azilnik/kindle-sky/docs/images/frame.jpg

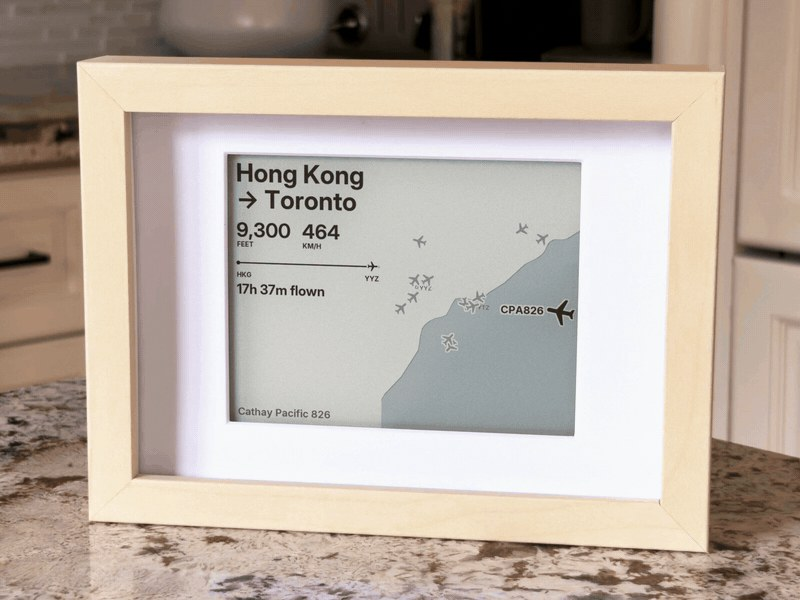
docs/images/frame.jpg
