azilnik/kindle-sky/docs/images/hero.png

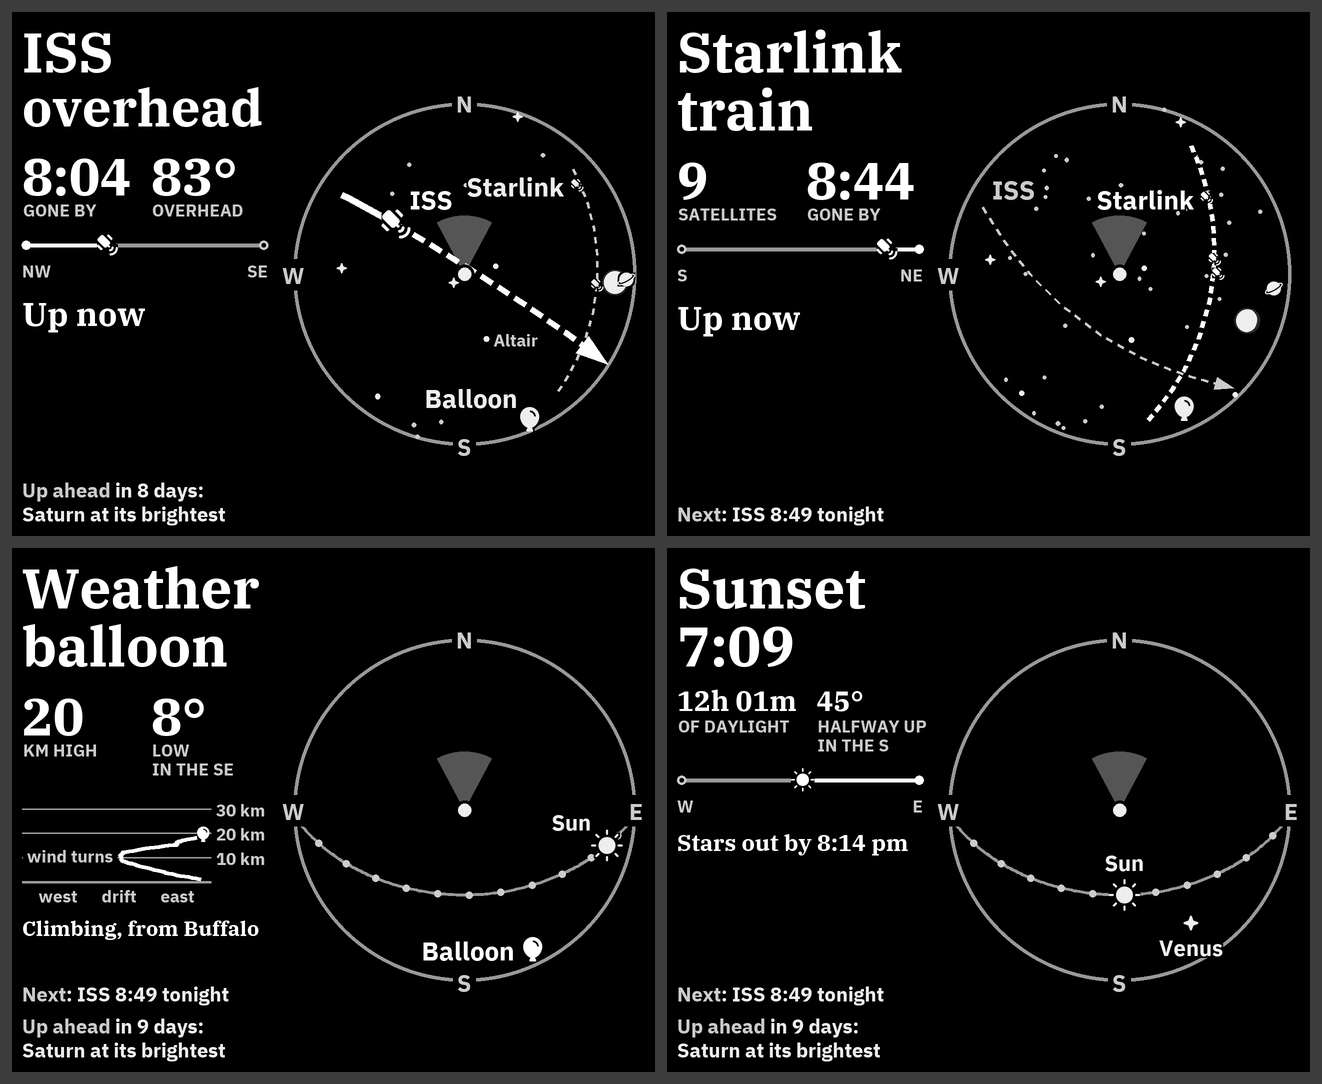
docs/images/hero.png
