azilnik/kindle-sky/insert/plate-rodalm13x18-pw2.3mf

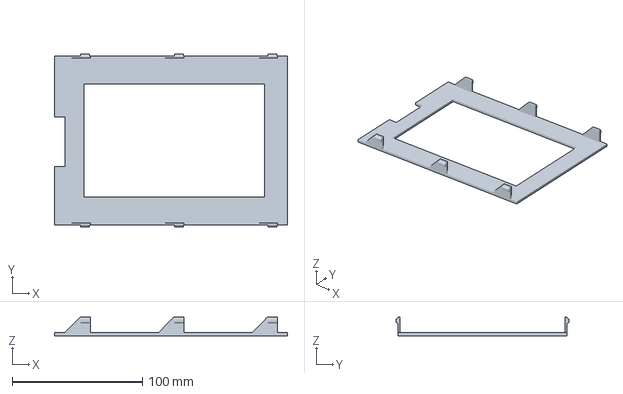
[picture p7: CAD file, 2026-10-16]
insert/plate-rodalm13x18-pw2.3mf
179.0 x 133.0 x 14.4 mm
