azilnik/kindle-sky/insert/solar-rodalm13x18-pw2.3mf

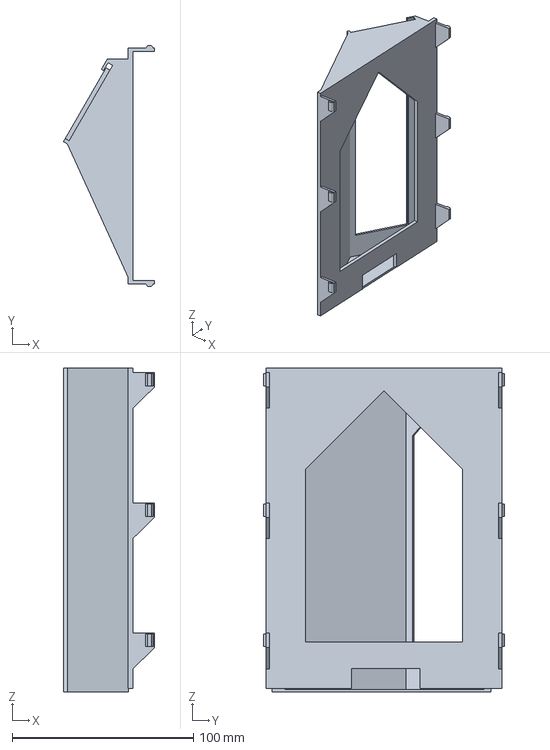
[picture p8: CAD file, 2026-10-16]
insert/solar-rodalm13x18-pw2.3mf
50.4 x 133.0 x 179.0 mm
