azilnik/kindle-sky/insert/insert-rodalm13x18.3mf

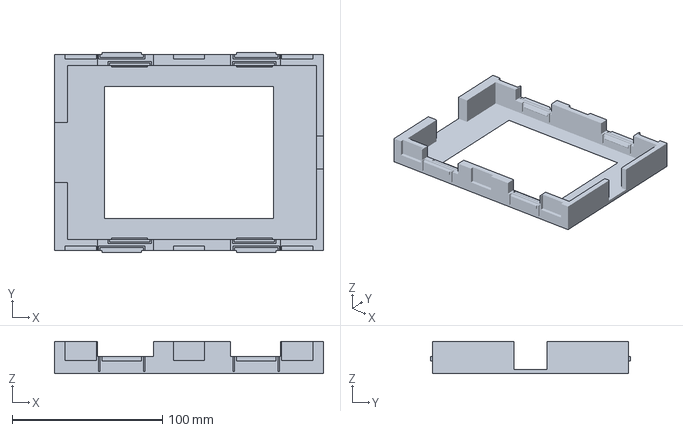
[picture p9: CAD file, 2026-10-16]
insert/insert-rodalm13x18.3mf
179.0 x 133.0 x 21.6 mm
