azilnik/kindle-sky/insert/insert-rodalm21x30.3mf

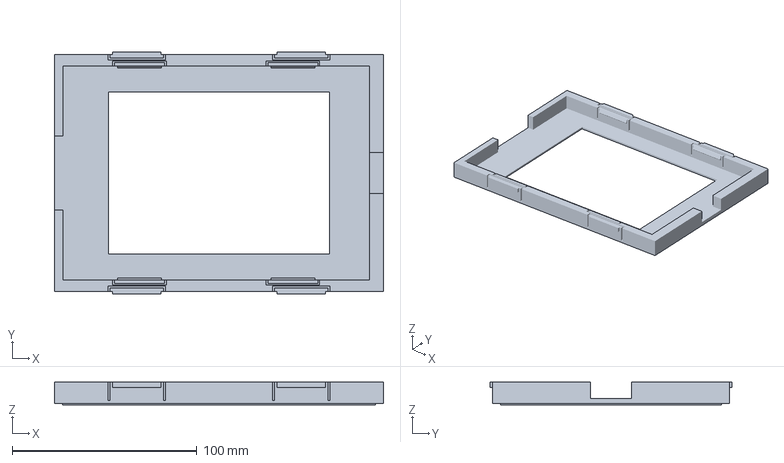
[picture p10: CAD file, 2026-10-16]
insert/insert-rodalm21x30.3mf
178.0 x 130.8 x 12.4 mm
