azilnik/kindle-sky/insert/backing-rodalm13x18.3mf

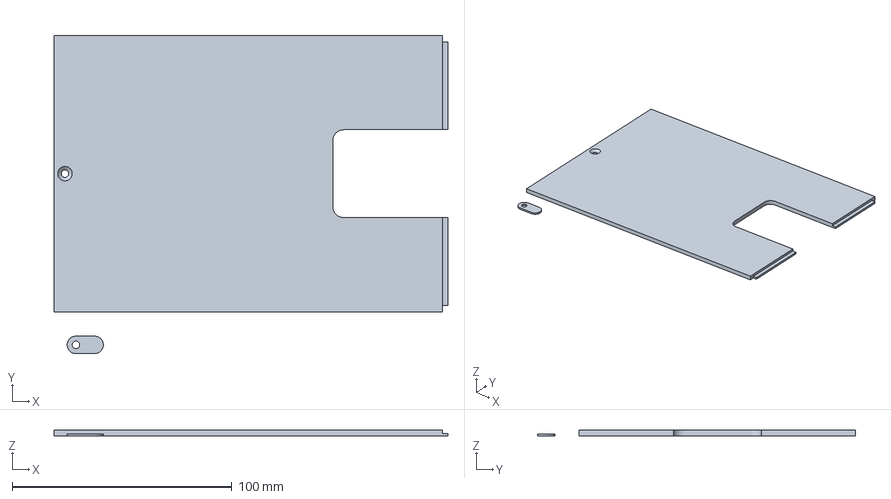
[picture p11: CAD file, 2026-10-14]
insert/backing-rodalm13x18.3mf
179.5 x 145.0 x 2.70 mm
