azilnik/kindle-sky/(list of files, cad)

Other CAD files:
insert/plate-rodalm13x18.3mf
insert/backing-rodalm13x18.stl
insert/insert-rodalm21x30.stl
insert/plate-rodalm13x18-pw2.stl
insert/solar-rodalm13x18-pw2.stl
