azilnik/kindle-sky/(commit log)

2026-10-02 docs: the sky frame on battery, 4.7 mA, about 13 days a charge
    Measured on the framed PW4 over 27 clean hours: 5 mA by day, 3.5 mA at
    night, against the planes frame's ~11 mA. It joins Wi-Fi about 65 times
    a day, mostly around the two daily weather balloon launches.
2026-10-09 feat(insert): measured fit, walls to the frame's depth, and a back plate
    The RÖDALM 13x18 measures 183 x 131.2 x 24 with its inner frame out, and
    both Kindles are measured now. The insert fills the frame's depth, its
    lips press on the Kindle's rounded back edge, and room is left for a
    right-angle plug. A back plate closes it flush, held by spring fingers.
    The insert sits centered, sliding toward the far end only when its far
    wall would drop under 2.5 mm, and keeps 0.5 mm from the frame at both ends.
2026-10-09 feat(insert): a solar backing for the PW2, and gauges to size it
    The backing holds a USB solar panel at 60° behind the plate, with the
    plug and cable inside it. The gauges size the Kindle and test-fit the
    panel.
2026-10-09 chore: the PW4's safe for its new insert, with the usual 12 px inset
2026-10-13 feat: the sky frame opens with a letter, and one press shows the sky
    tools/gift.sh leaves a letter on the Kindle in place of the sky, set on a
    baseline grid in the frame's own type, with a three-star constellation beside
    the greeting. Its Next line says to press the power button; that first press
    puts the letter away (gift.seen) and flashes the sky in.
2026-10-13 feat: the letter comes back every year on its day, and stays in the library
    The first opening writes gift.date; each year on that date the letter is back
    on the screen until pressed again. gift.sh also leaves it in the Kindle's
    library as a book, and run.sh stop now starts the reader services it stopped,
    so the library opens when the frame hands the screen back.
2026-10-14 feat: a printed back board with an opening for the charger and power button
    Holds like the stock 5x7 board: a 1.2 mm lip in the groove on the port side, a turn tab
    on an M3 screw on the far side. The opening is open to the port edge and spans the
    insert's 40 mm cable slot, with room behind the U-turn adapter for a plug.
    Claude-Session: https://claude.ai/code/session_01G9Y5M99cvSHVUS5a2JJoAP
2026-10-14 fix: the back board at the stock board's measured 178 x 126
    1 mm shorter and a 2.5 mm lip, so it stays inside the A1 mini's 180 mm bed.
    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
2026-10-14 docs: tidy the back board's notes
    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
2026-10-14 chore: regenerated back board 3mf
    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
2026-10-16 fix(pw2): a charger's or solar panel's wake sleeps again, and a press is read across suspend
2026-10-16 refactor!: the sky frame only, in sky/, with the planes frame gone
    planes.py, its samples, shoreline and fonts are deleted. What sky.py used from it moves to
    base.py; every sample renders pixel-identical on both models and the simulator passes.
    The device path is /mnt/us/sky and the boot job sky.conf; install.sh moves an old
    /mnt/us/planes install over, settings and gift letter included, and takes --home.
2026-10-16 feat(insert): a back plate for the PW2, and the print guide per Kindle
    Every mesh regenerates byte-identical from its script. The PW2 gets its own plate, since
    its fingers sit elsewhere than the PW4's. The back board doesn't fit behind the
    full-depth inserts and says so; insert.py --plate on a frame without a depth exits
    cleanly. Docs images now show the sky.
2026-10-16 docs: the sky frame's README, agent playbooks, and docs without planes
2026-10-16 cleanup: the sky samples without the planes they carried
2026-10-16 docs: the hero is the sky frame on the counter, a day in 25 seconds
2026-10-16 feat(tools): the hero as a square video, with a slow camera, for social feeds
2026-10-16 feat(tools): the promo as a seamless loop of one evening into the next morning
    The camera only breathes (about 6% in during the pass) with a gimbal's faint tremor and
    the kitchen moving less than the frame. Pages change as e-ink does, erase then draw over
    120 ms with the old page left as a faint ghost, carried across the wrap. The room's light
    follows the day. One keyframe and no B-frames, so the grain doesn't pulse. Every screen's
    Next and Up ahead agree with the ones after it. Three rounds of blind review: the seam,
    camera and encoding pass by measurement.
    fix: the Starlink name rides one satellite on the train's own path, not a stray elsewhere
    in the sky or whichever is highest this minu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
2026-10-16 cleanup: no webcam tooling, and the promo video lives outside the repo
    camshot.sh and photobooth-window.swift grabbed a Photo Booth window from the Mac's
    webcam to look at the frame; they had no place in a public repo. promo.py, which made
    the social video, moved out. The SSH setup's folder on the Kindle is kindle-usbnet.
